ferjomendez/RockU/docs/graficos_ppt/01_resumen_exactitud.png

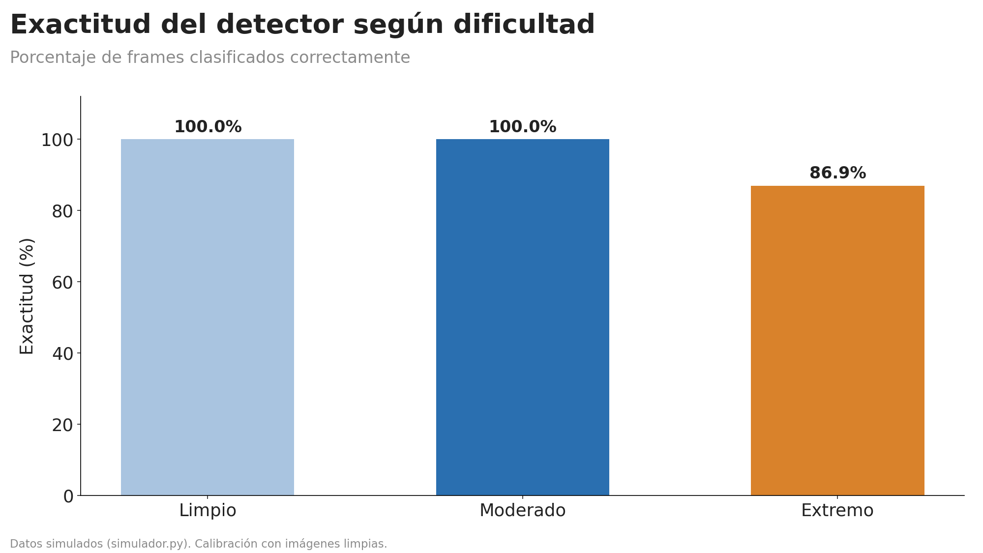
docs/graficos_ppt/01_resumen_exactitud.png
