ferjomendez/RockU/docs/graficos_ppt/02_f1_por_clase_niveles.png

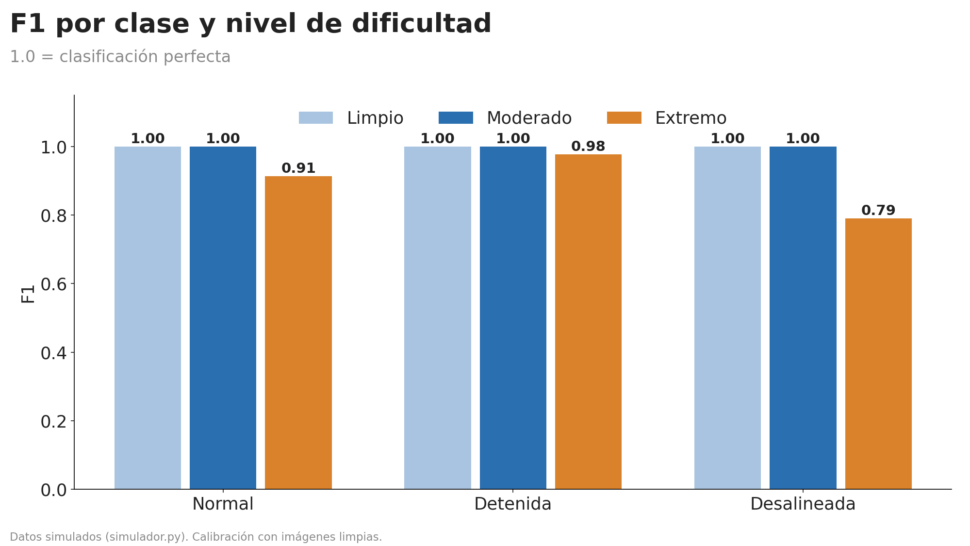
docs/graficos_ppt/02_f1_por_clase_niveles.png
