ferjomendez/RockU/docs/graficos_ppt/03_precision_recall_extremo.png

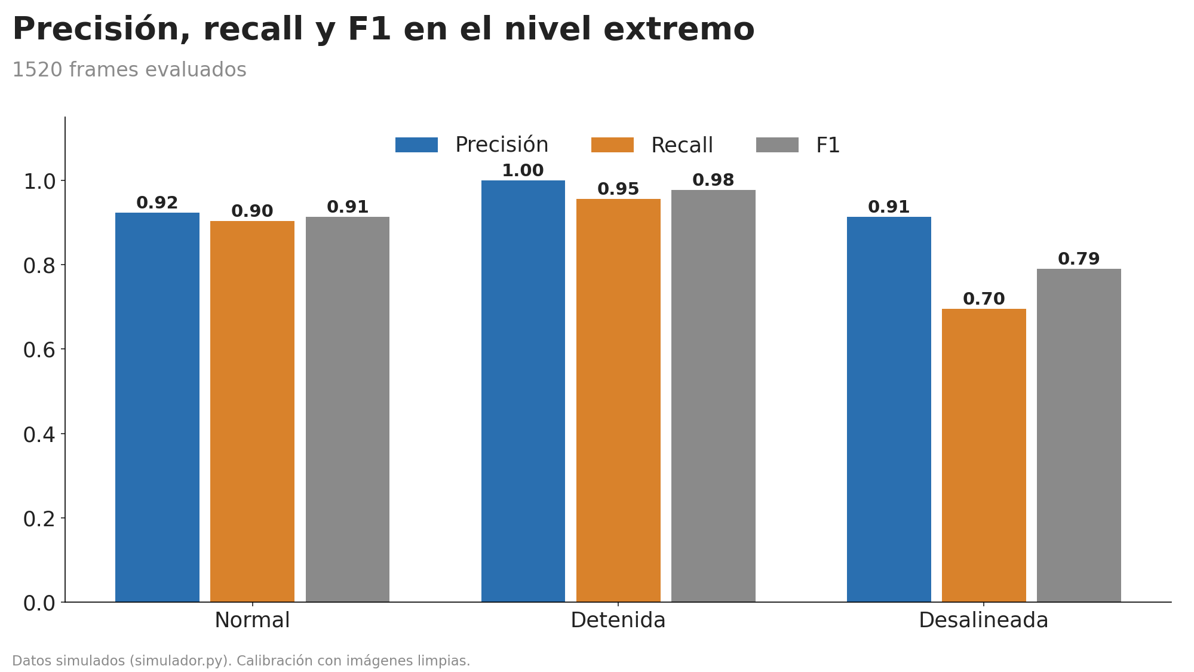
docs/graficos_ppt/03_precision_recall_extremo.png
