ferjomendez/RockU/docs/graficos_ppt/04_matriz_confusion_extremo.png

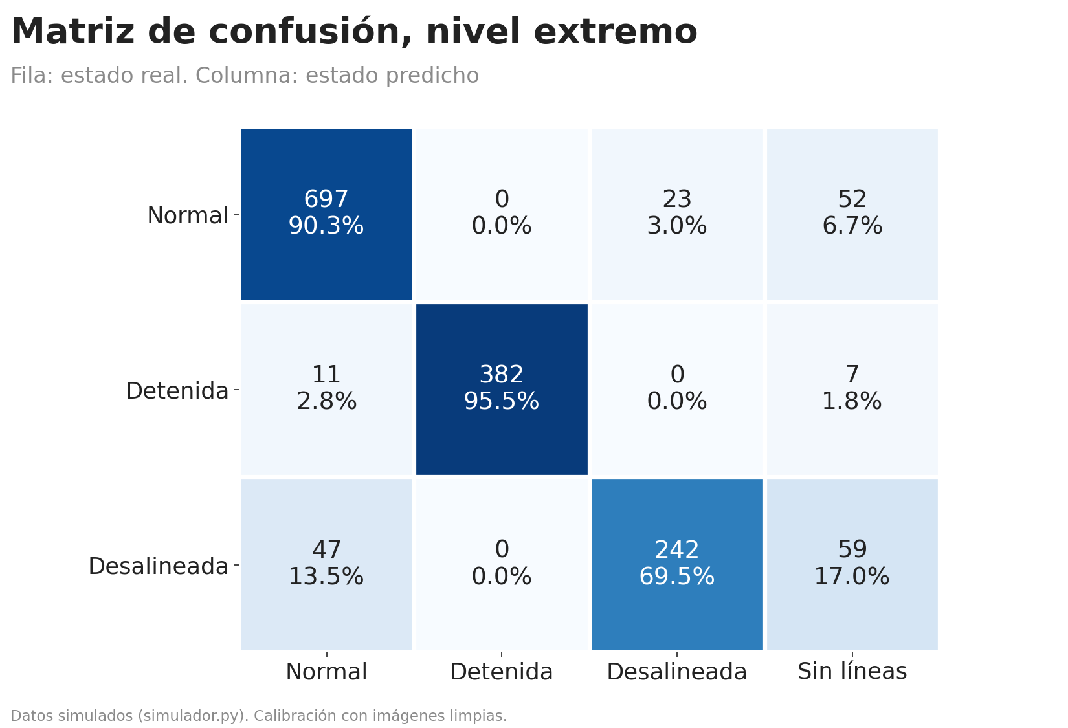
docs/graficos_ppt/04_matriz_confusion_extremo.png
