ferjomendez/RockU/docs/graficos_ppt/05_exactitud_por_grupo.png

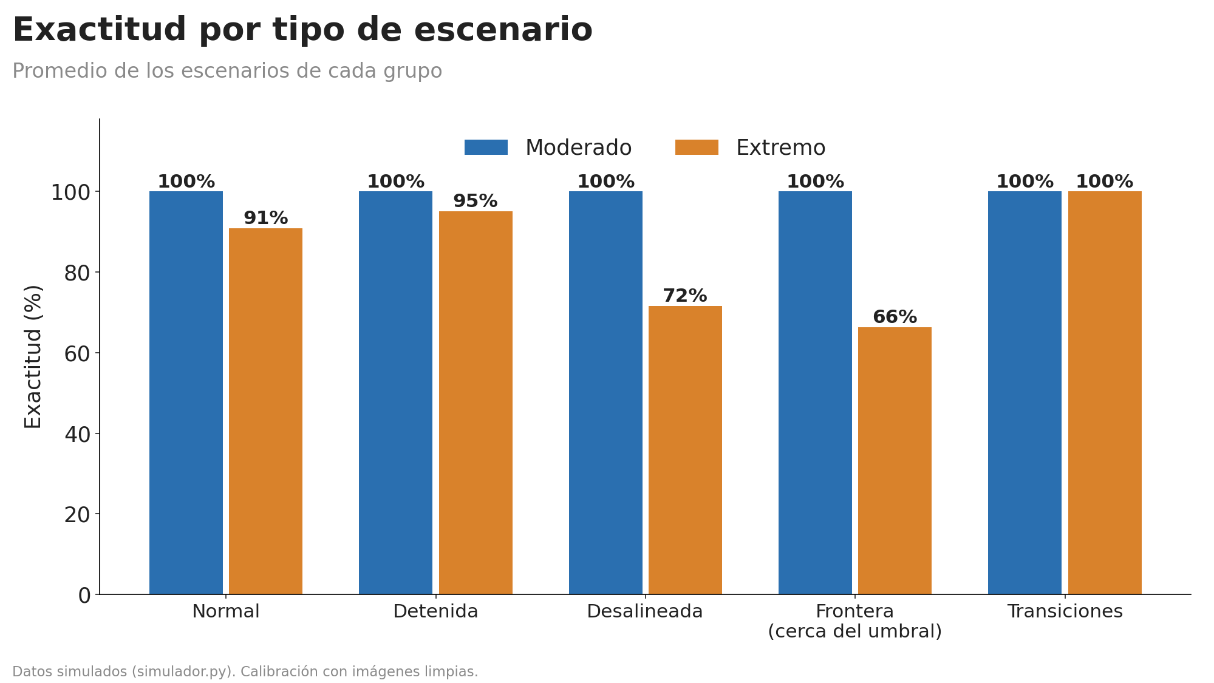
docs/graficos_ppt/05_exactitud_por_grupo.png
