ferjomendez/RockU/docs/graficos_ppt/06_modos_de_falla.png

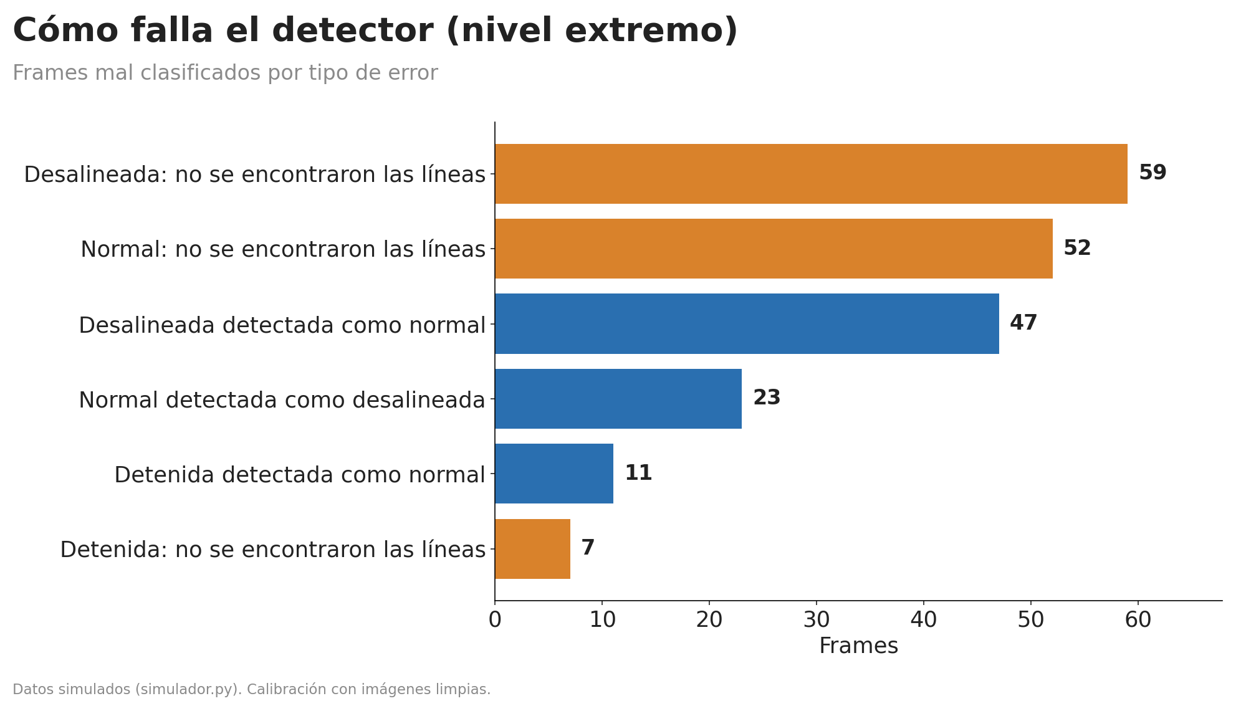
docs/graficos_ppt/06_modos_de_falla.png
