ferjomendez/RockU/docs/graficos_ppt/07_sensibilidad_lateral.png

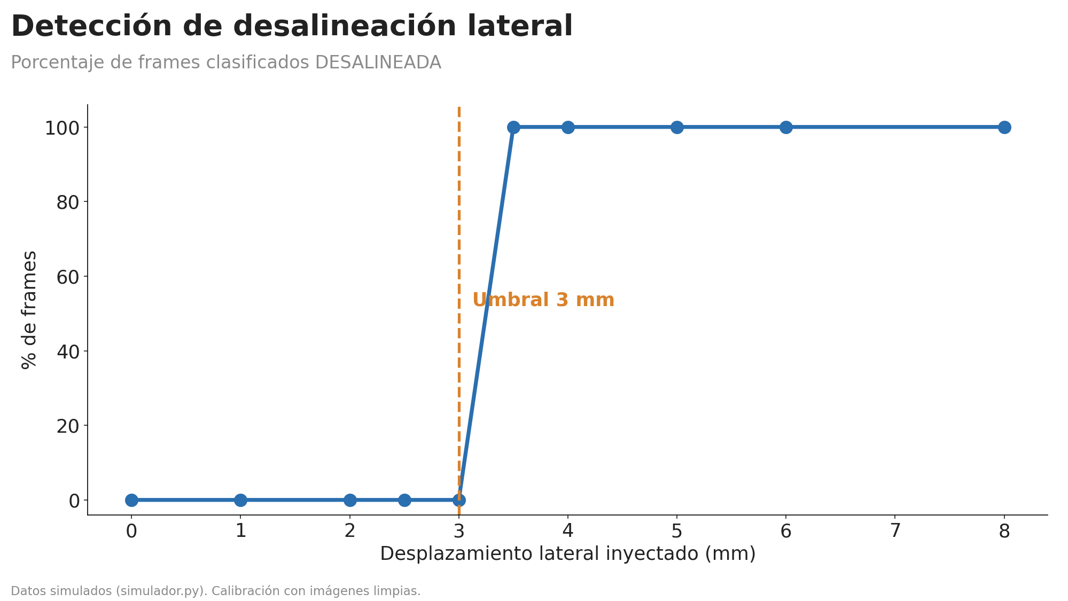
docs/graficos_ppt/07_sensibilidad_lateral.png
