ferjomendez/RockU/docs/graficos_ppt/08_sensibilidad_angulo.png

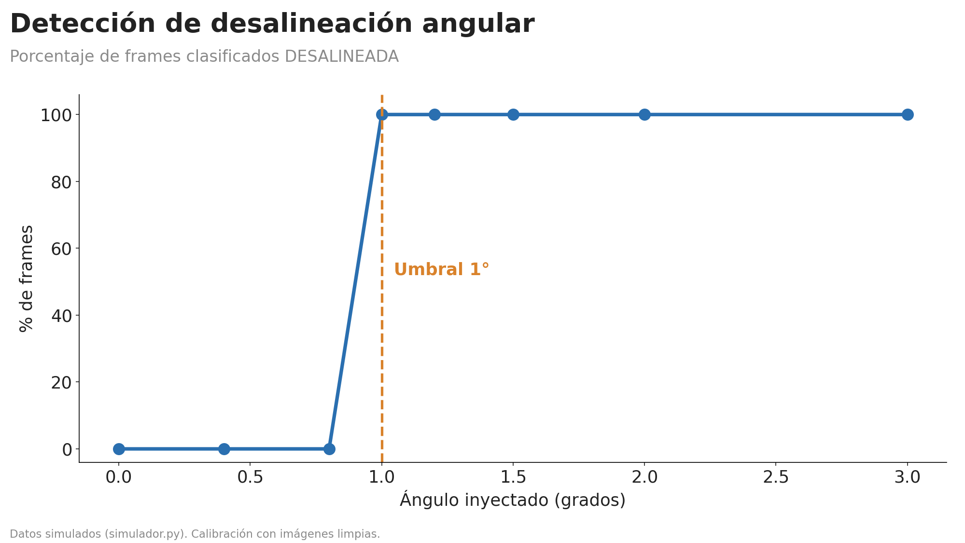
docs/graficos_ppt/08_sensibilidad_angulo.png
