ferjomendez/RockU/docs/graficos_ppt/09_sensibilidad_velocidad.png

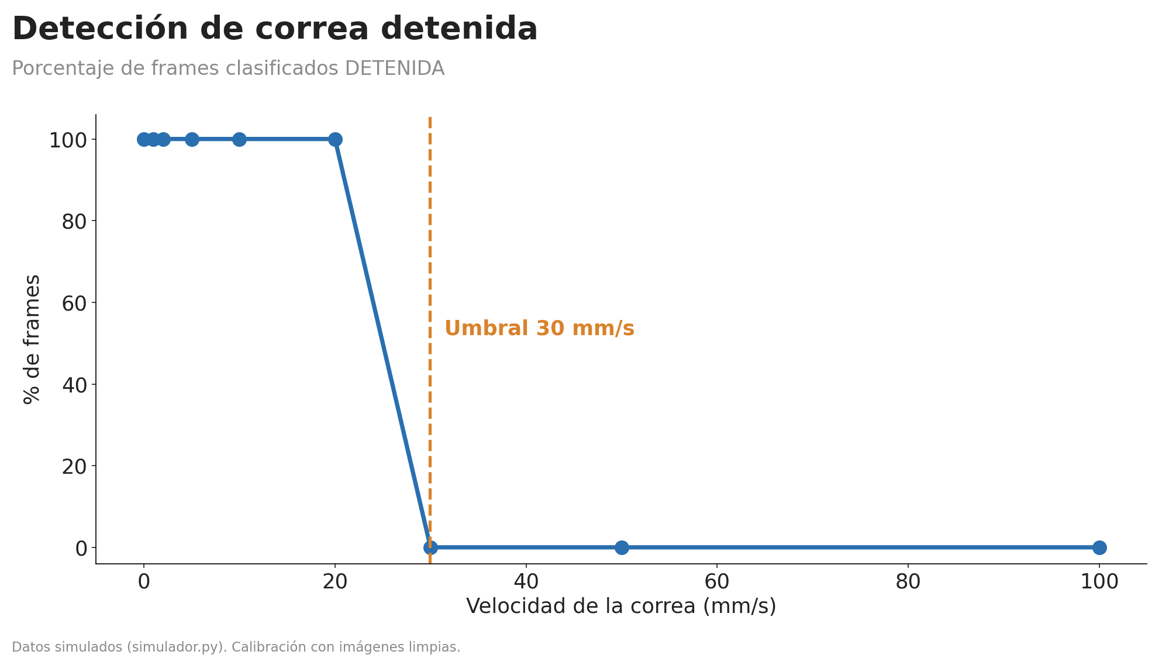
docs/graficos_ppt/09_sensibilidad_velocidad.png
