ferjomendez/RockU/docs/graficos_ppt/10_errores_medicion.png

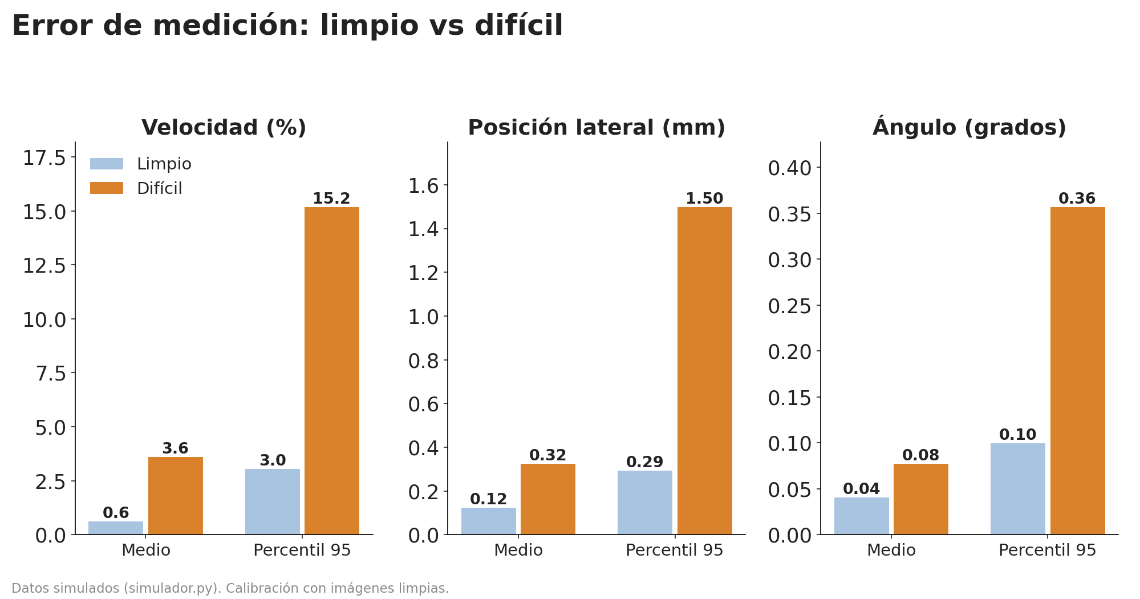
docs/graficos_ppt/10_errores_medicion.png
