ferjomendez/RockU/docs/graficos_ppt/11_latencia_confirmacion.png

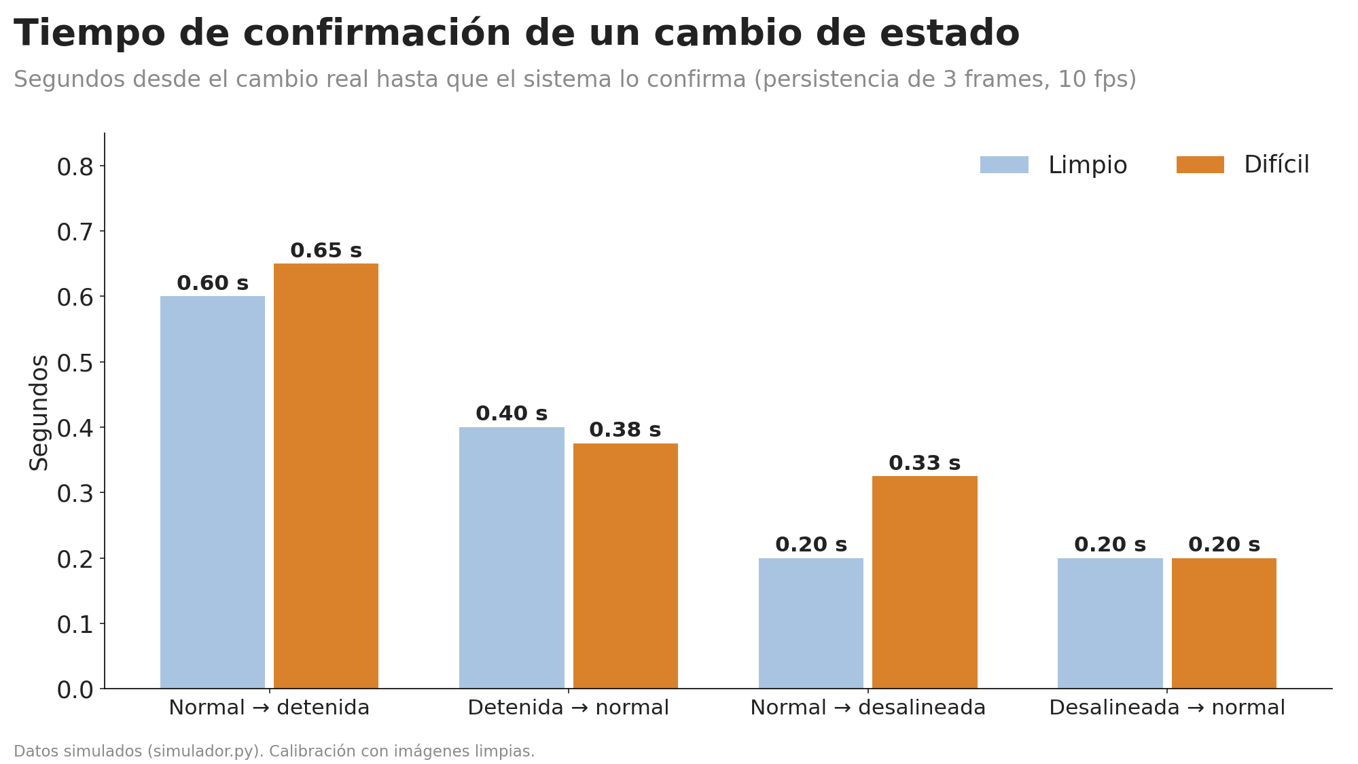
docs/graficos_ppt/11_latencia_confirmacion.png
