ferjomendez/RockU/docs/graficos_ppt/12_peores_escenarios.png

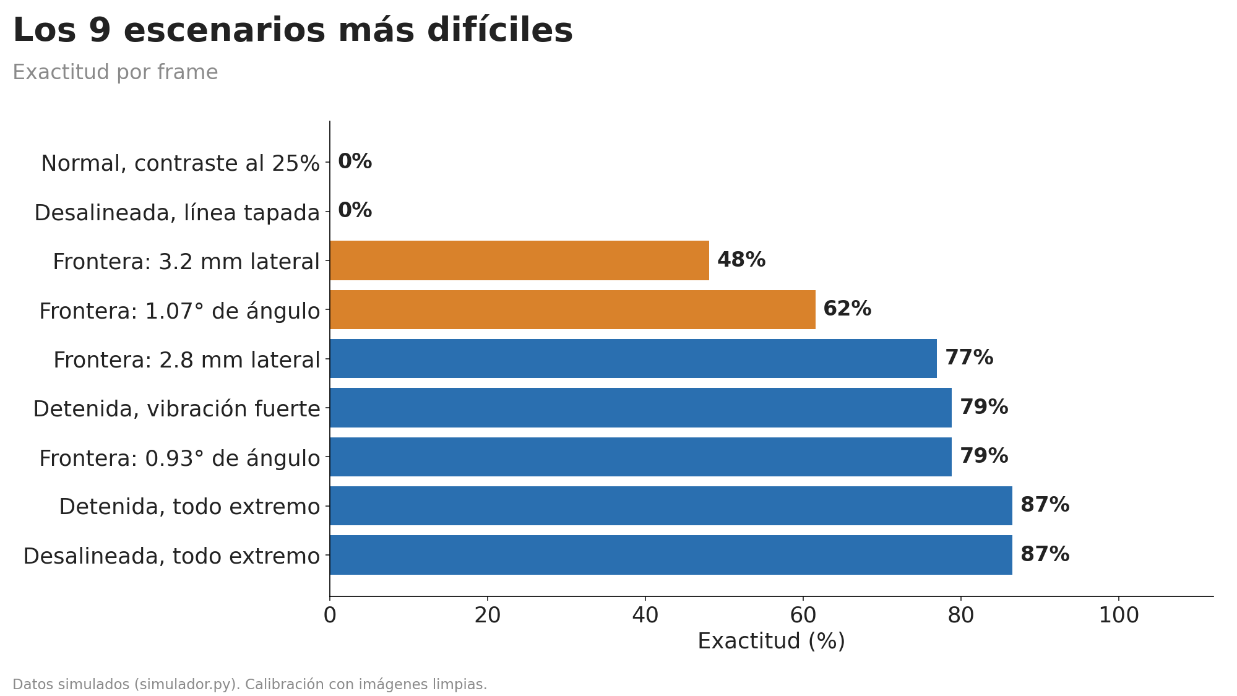
docs/graficos_ppt/12_peores_escenarios.png
