ferjomendez/RockU/docs/graficos_ppt/13_tabla_condiciones.png

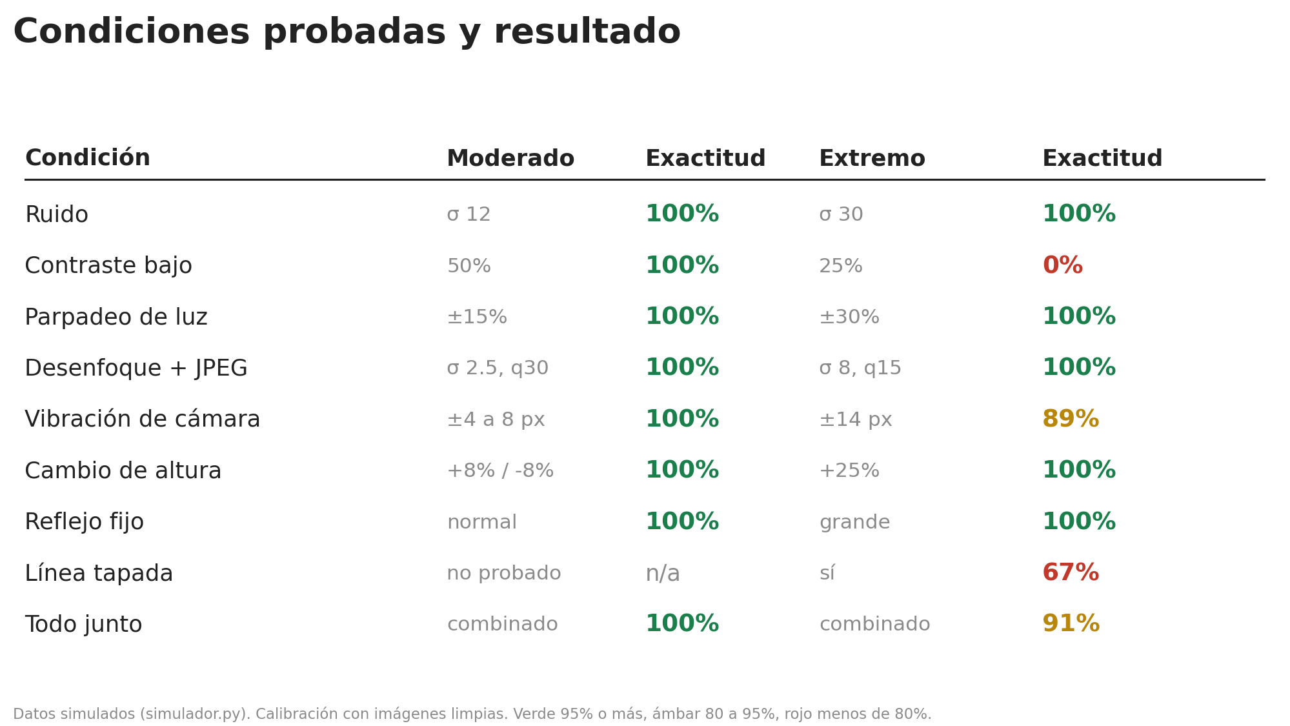
docs/graficos_ppt/13_tabla_condiciones.png
