ferjomendez/RockU/docs/metricas/matriz_confusion.png

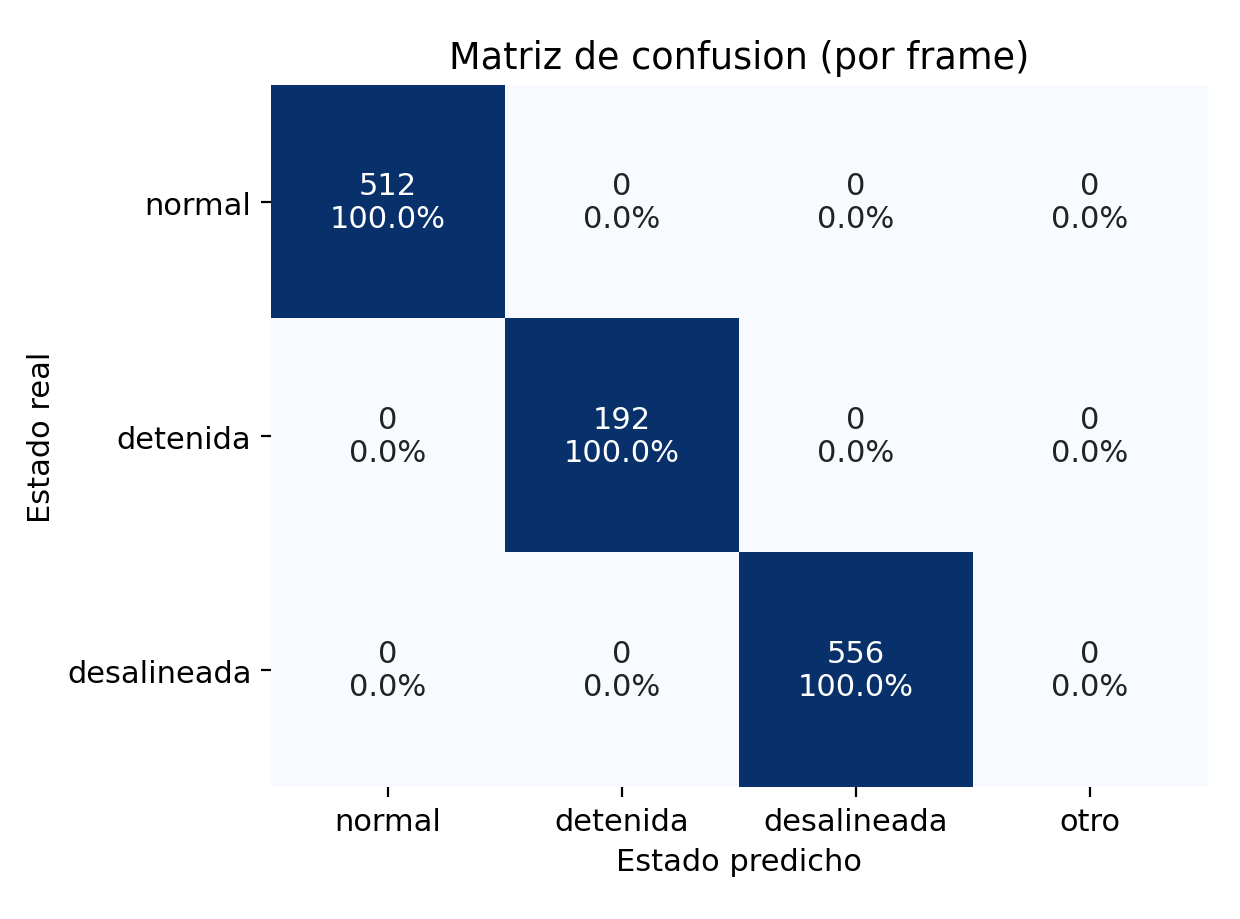
docs/metricas/matriz_confusion.png
