ferjomendez/RockU/docs/metricas/prf_por_clase.png

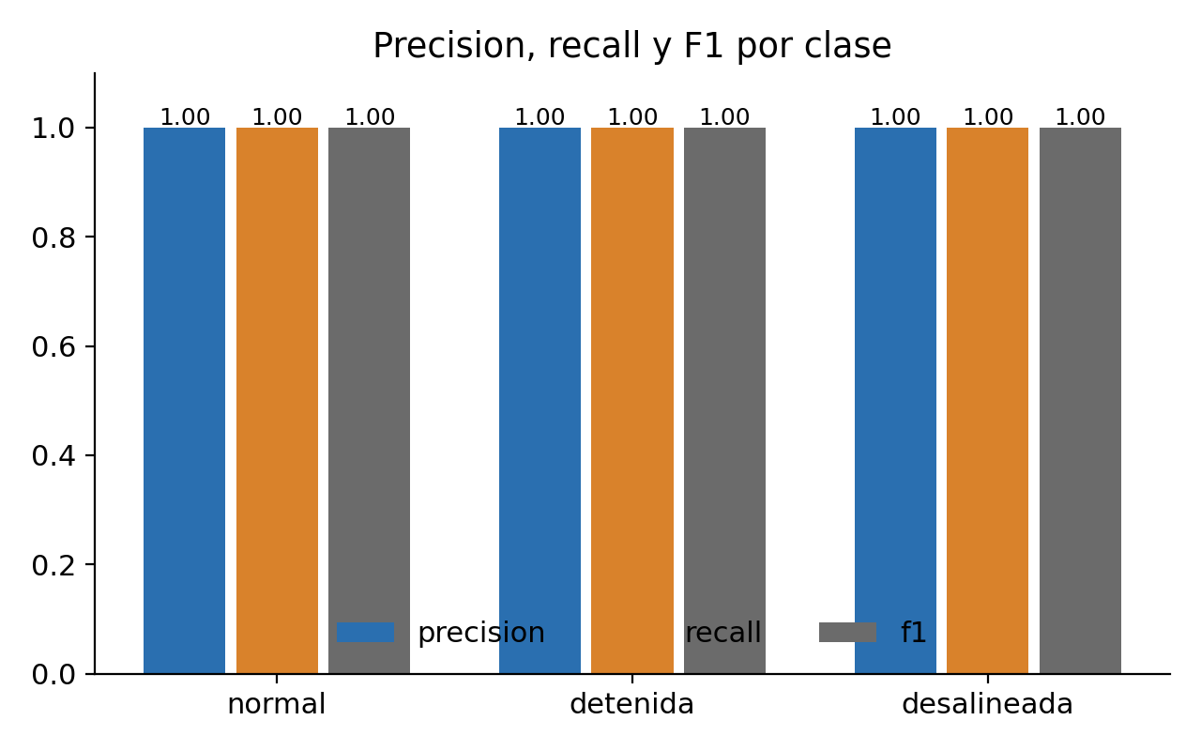
docs/metricas/prf_por_clase.png
