ferjomendez/RockU/docs/metricas/sensibilidad.png

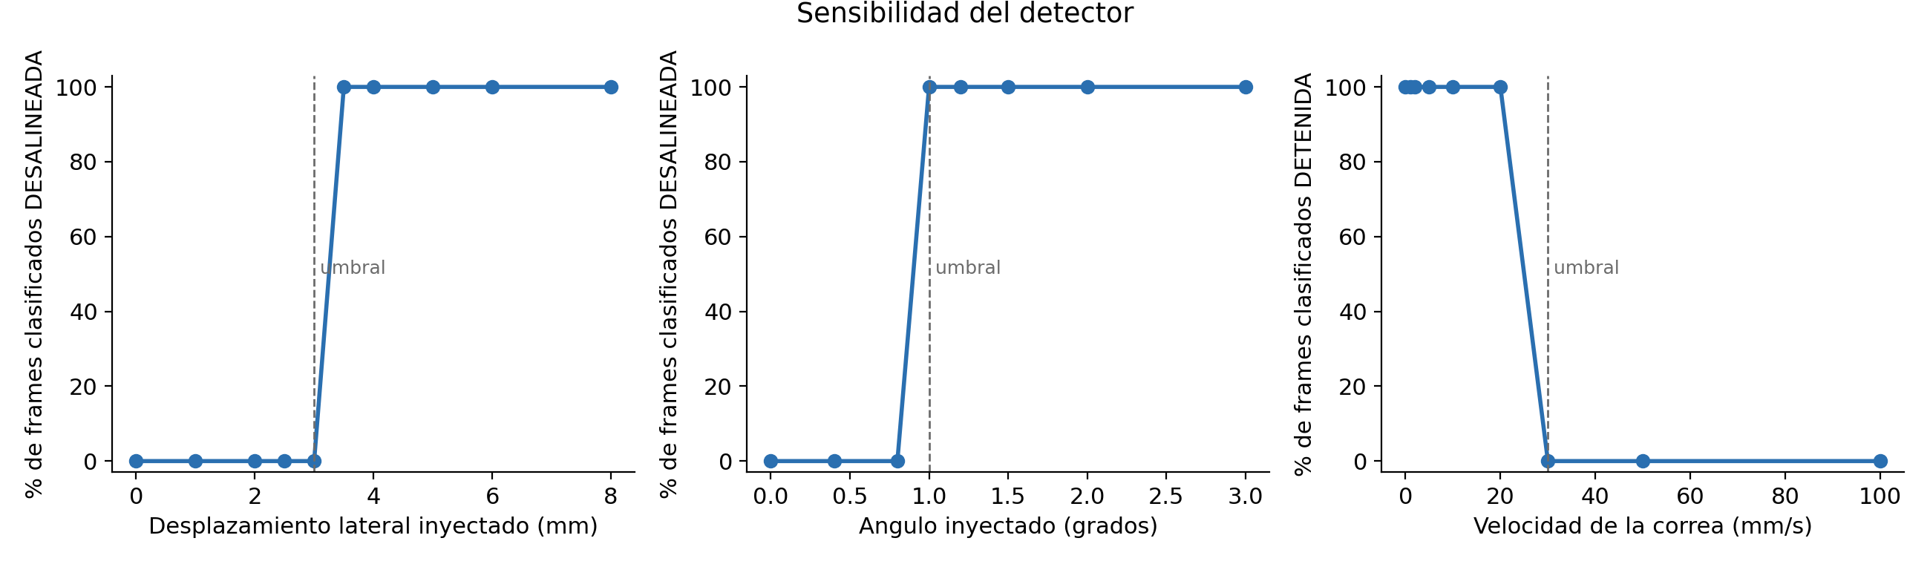
docs/metricas/sensibilidad.png
