ferjomendez/RockU/docs/metricas_dificil/exactitud_por_escenario.png

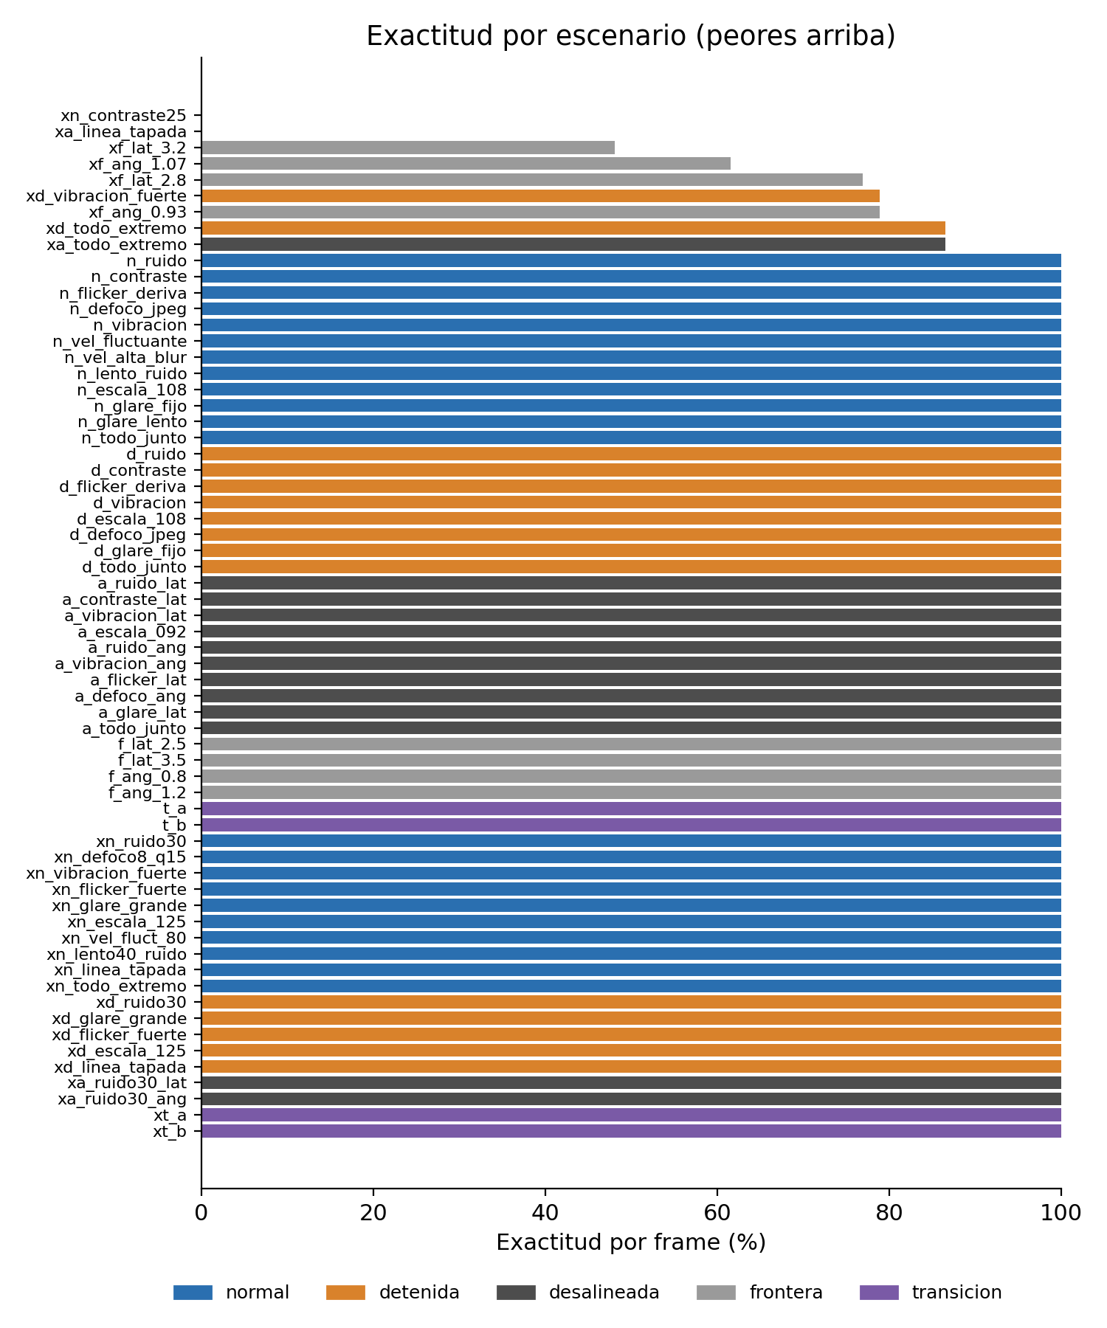
docs/metricas_dificil/exactitud_por_escenario.png
