ferjomendez/RockU/docs/metricas_dificil/matriz_confusion_dificil.png

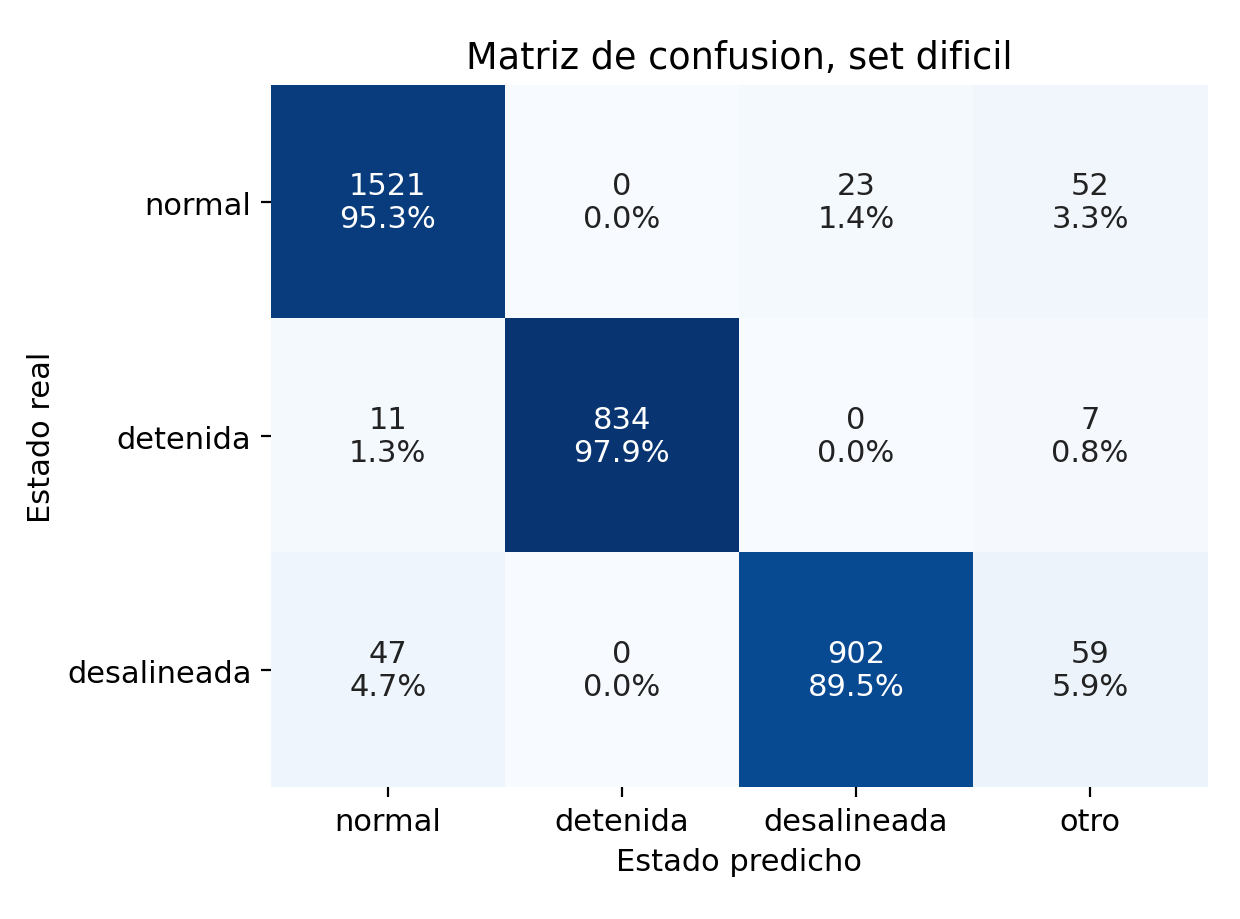
docs/metricas_dificil/matriz_confusion_dificil.png
