ferjomendez/RockU/Perfboard controlador motor/Perfboard controlador motor.stl

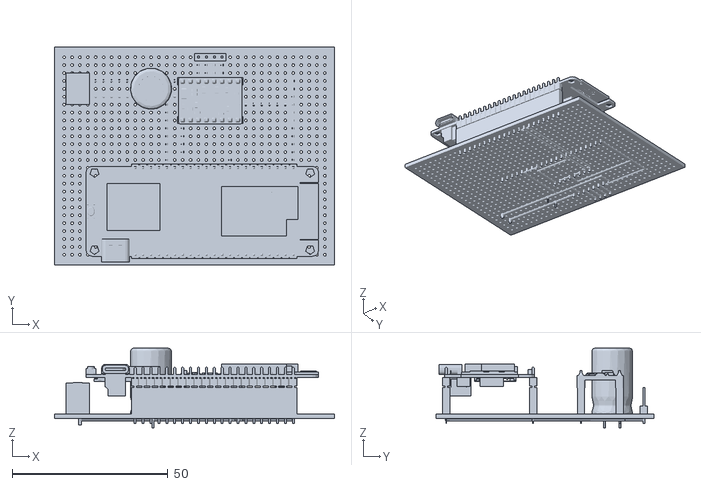
[picture p27: CAD file, 2026-10-14]
Perfboard controlador motor/Perfboard controlador motor.stl
90.0 x 70.0 x 25.7
