ferjomendez/RockU/(list of files, cad)

Other CAD files:
Perfboard controlador motor/Perfboard controlador motor.f3d
