ferjomendez/RockU/(commit log)

2026-09-30 Proyecto Android: app CorreaCam con servidor HTTP de captura
2026-09-30 Scripts de Raspberry Pi: grabación, análisis y simulador
2026-10-14 Renombrar carpeta de la perfboard y agregar modelo STL
    Se renombra perfboard_controlador_motor a "Perfboard controlador motor"
    para que coincida con el nombre del modelo en Fusion. Se agrega el STL,
    los links en el README y la nota sobre modelos de terceros. Se ignora
    3D models/ para no subir por accidente modelos pesados de terceros.
    [Perfboard controlador motor.f3d, Perfboard controlador motor.stl]
2026-10-14 Agregar firmware de prueba del motor paso a paso
    Sketch test_motor para ESP32 TTGO T-Call con driver A4988. El pin
    ENABLE pasa de GPIO32 a GPIO25, porque GPIO32 es el DTR del SIM800L.
2026-10-21 Agrega evaluacion de metricas del detector con datos sinteticos
2026-10-21 Agrega graficos para presentacion de metricas del detector
2026-10-23 Agrega panel web y pantalla mini del dashboard (version simulador)
    Panel completo (index.html) y pantalla de 3.5 pulgadas (mini.html) con el
    estilo del logo, tema claro y oscuro, simulador de fallas en el navegador y
    adaptador remote.js para consumir la API del servidor.
2026-10-23 Agrega servidor Flask con API, SSE, registro SQLite y exportacion CSV
    Fuente simulada y fuente real (telefono, Detector, Clasificador y eventos del
    ESP32), contrato en docs/api.md, servicio systemd de ejemplo, pruebas y
    seccion nueva en el README.
